esk8b/Elektroskate_Controller/PCB/BamBam-Sensor-holder-minimal/Sensor v1.2.dxf

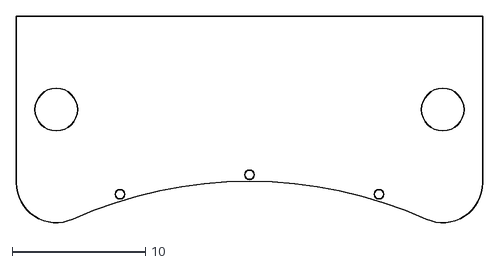
[picture p1: CAD file, 2015-05-01]
PCB/BamBam-Sensor-holder-minimal/Sensor v1.2.dxf
35.0 x 15.6
