esk8b/Elektroskate_Controller/PCB/BamBam-Sensor-holder-minimal/BamBam-Sensor-holder-minimal.pdf

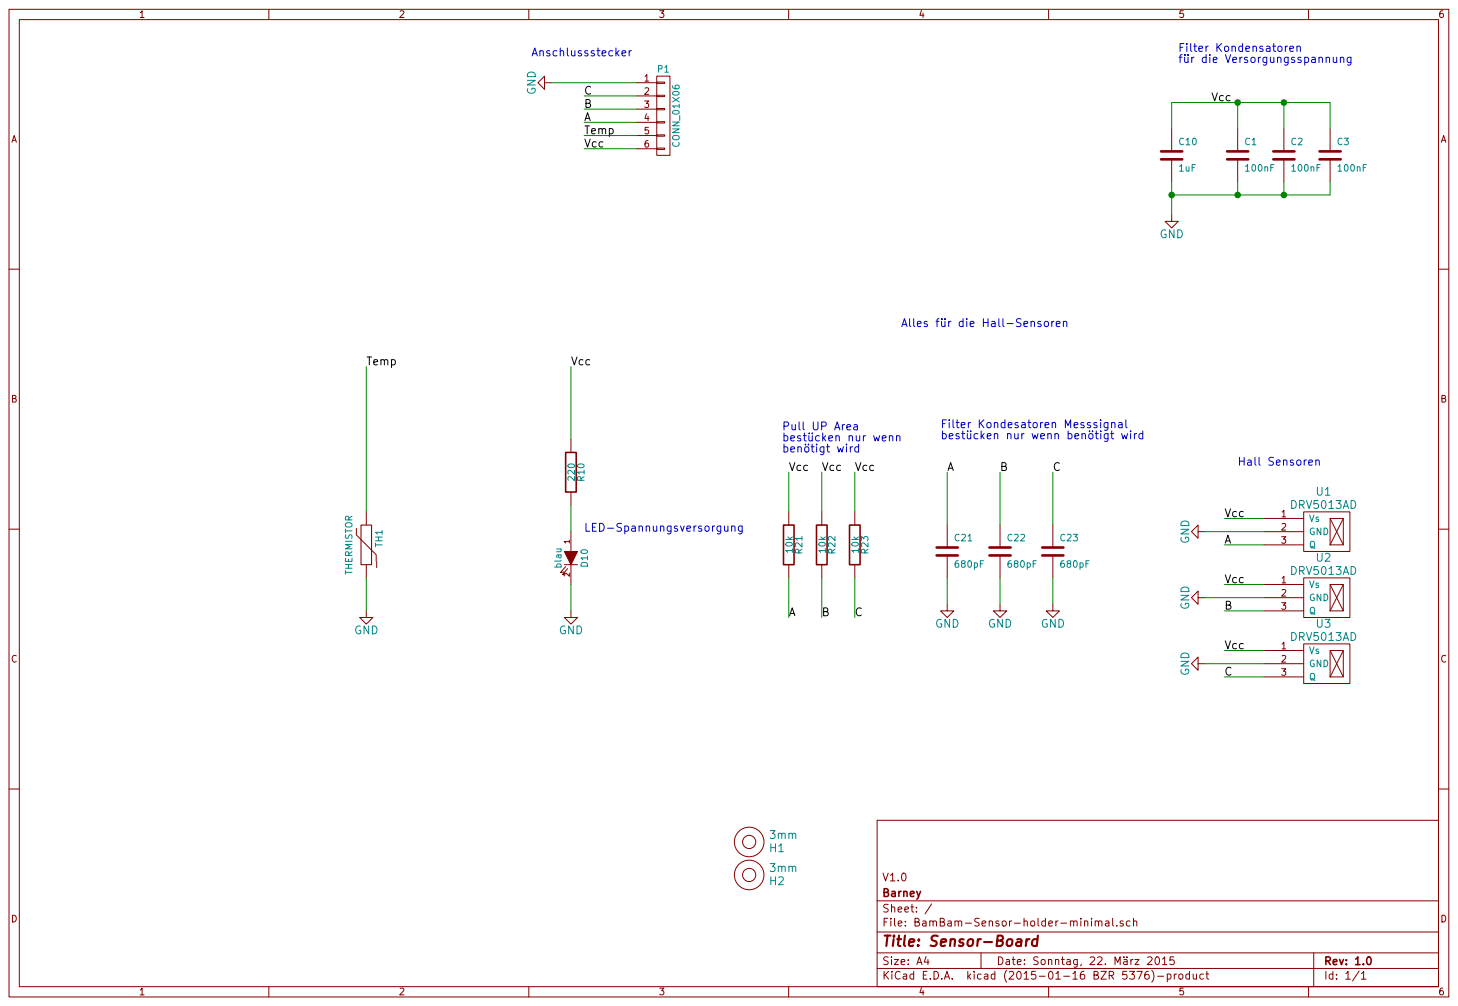
[picture p2: page 1]

Filter Kondesatoren Messsignal
bestücken nur wenn benötigt wird

File: BamBam-Sensor-holder-minimal.sch Sheet: / Barney V1.0 220 R10

Id: 1/1 Title: Sensor-Board
