esk8b/Elektroskate_Controller/PCB/BamBam BoardController/BamBam BoardController.pdf

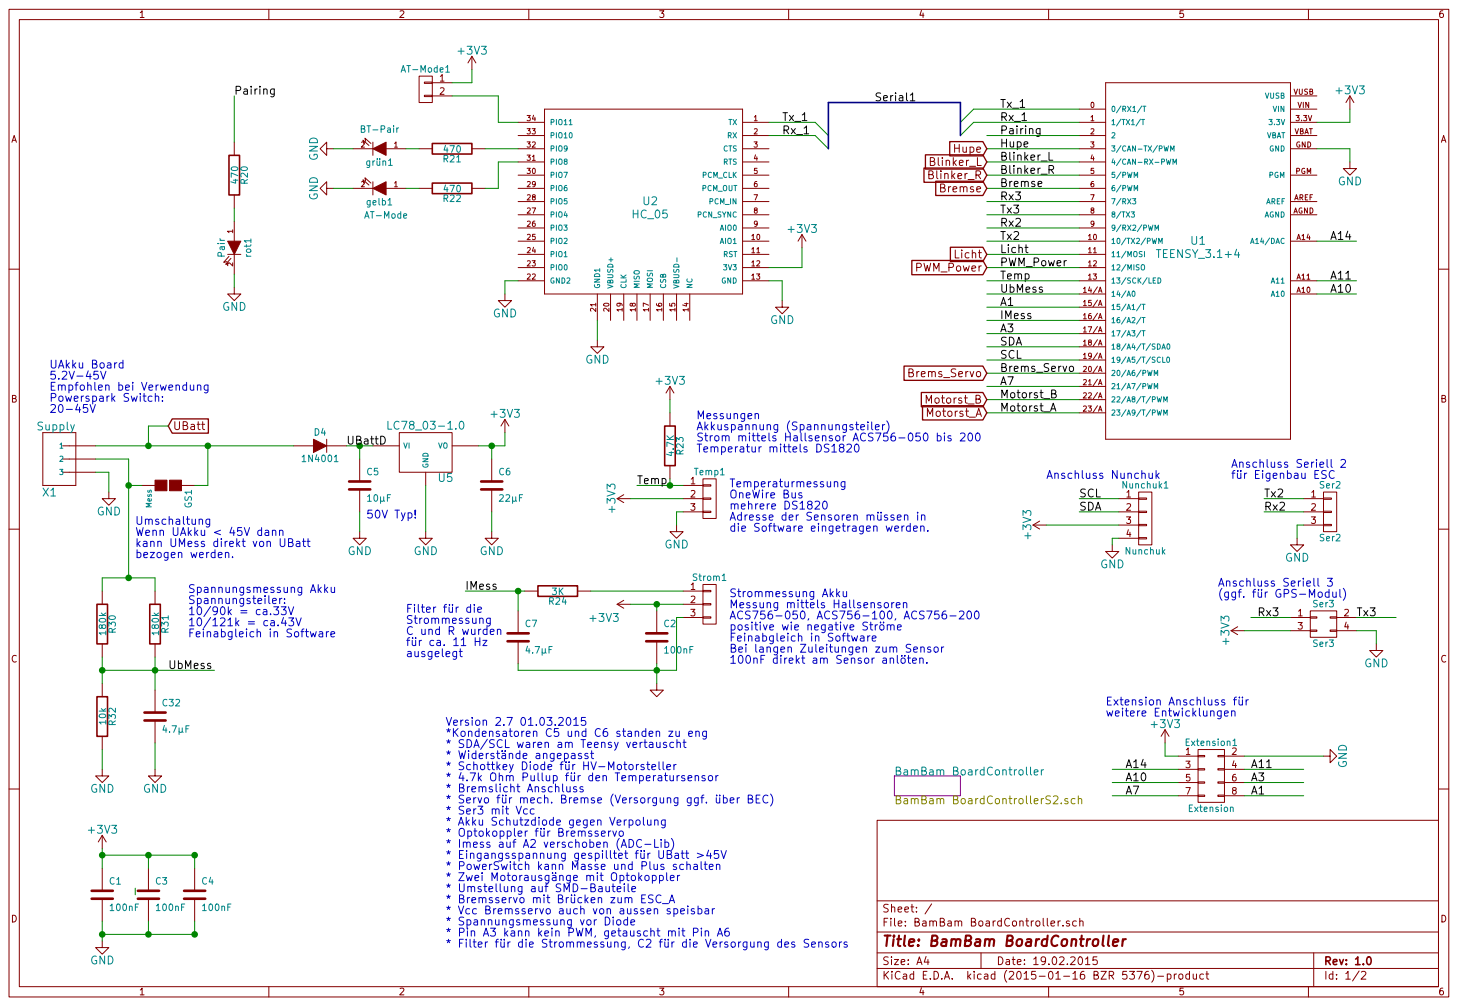
[picture p3: page 1]

100nF direkt am Sensor anlöten. +3V34.7K R23

Akkuspannung (Spannungsteiler)
Strom mittels Hallsensor ACS756-050 bis 200

Temperaturmessung
OneWire Bus
mehrere DS1820
Adresse der Sensoren müssen in
die Software eingetragen werden.

IMess Filter für die Strommessung

Strommessung Akku
Messung mittels Hallsensoren
ACS756-050, ACS756-100, ACS756-200
positive wie negative Ströme
Feinabgleich in Software
Bei langen Zuleitungen zum Sensor

*Kondensatoren C5 und C6 standen zu eng
* SDA/SCL waren am Teensy vertauscht
* Widerstände angepasst
* Schottkey Diode für HV-Motorsteller
* 4.7k Ohm Pullup für den Temperatursensor * Bremslicht Anschluss
* Servo für mech. Bremse (Versorgung ggf. über BEC)
* Ser3 mit Vcc
* Akku Schutzdiode gegen Verpolung
* Optokoppler für Bremsservo
* Imess auf A2 verschoben (ADC-Lib)
* Eingangsspannung gespilltet für UBatt >45V
* PowerSwitch kann Masse und Plus schalten
* Zwei Motorausgänge mit Optokoppler
* Umstellung auf SMD-Bauteile
* Bremsservo mit Brücken zum ESC_A
* Vcc Bremsservo auch von aussen speisbar
* Spannungsmessung vor Diode
* Pin A3 kann kein PWM, getauscht mit Pin A6
* Filter für die Strommessung, C2 für die Versorgung des Sensors

Id: 1/2 Title: BamBam BoardController File: BamBam BoardController.sch Sheet: /

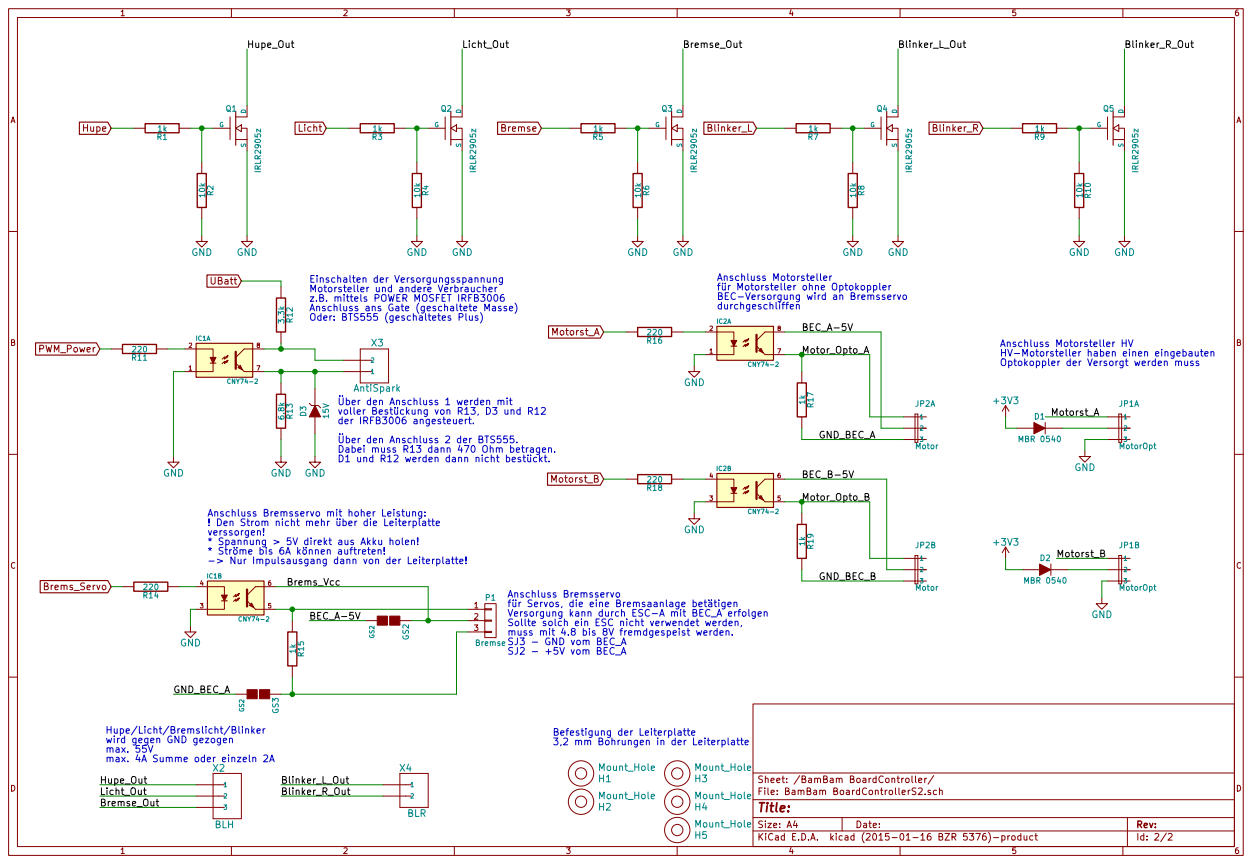
[picture p4: page 2]

Einschalten der Versorgungsspannung Motorsteller und andere Verbraucher z.B. mittels POWER MOSFET IRFB3006

für Motorsteller ohne Optokoppler
BEC-Versorgung wird an Bremsservo
durchgeschliffen

Anschluss ans Gate (geschaltete Masse)
Oder: BTS555 (geschaltetes Plus)

Anschluss Motorsteller HV HV-Motorsteller haben einen eingebauten
Optokoppler der Versorgt werden muss

Über den Anschluss 1 werden mit
voller Bestückung von R13, D3 und R12
der IRFB3006 angesteuert.
Über den Anschluss 2 der BTS555.

Anschluss Bremsservo mit hoher Leistung:
! Den Strom nicht mehr über die Leiterplatte
verssorgen!
* Spannung > 5V direkt aus Akku holen!
* Ströme bis 6A können auftreten!

für Servos, die eine Bremsaanlage betätigen
Versorgung kann durch ESC-A mit BEC_A erfolgen
Sollte solch ein ESC nicht verwendet werden,
muss mit 4.8 bis 8V fremdgespeist werden.
SJ3 - GND vom BEC_A
SJ2 - +5V vom BEC_A

Hupe/Licht/Bremslicht/Blinker
wird gegen GND gezogen max. 55V max. 4A Summe oder einzeln 2A

Befestigung der Leiterplatte
3,2 mm Bohrungen in der Leiterplatte

Id: 2/2 Title: File: BamBam BoardControllerS2.sch Sheet: /BamBam BoardController/
