esk8b/Elektroskate_Controller/PCB/BamBam-Sensor-holder-minimal/BamBam-Sensor-holder-minimal.kicad_pcb

## KiCad design PCB/BamBam-Sensor-holder-minimal/BamBam-Sensor-holder-minimal.kicad_pcb (2015-05-01)

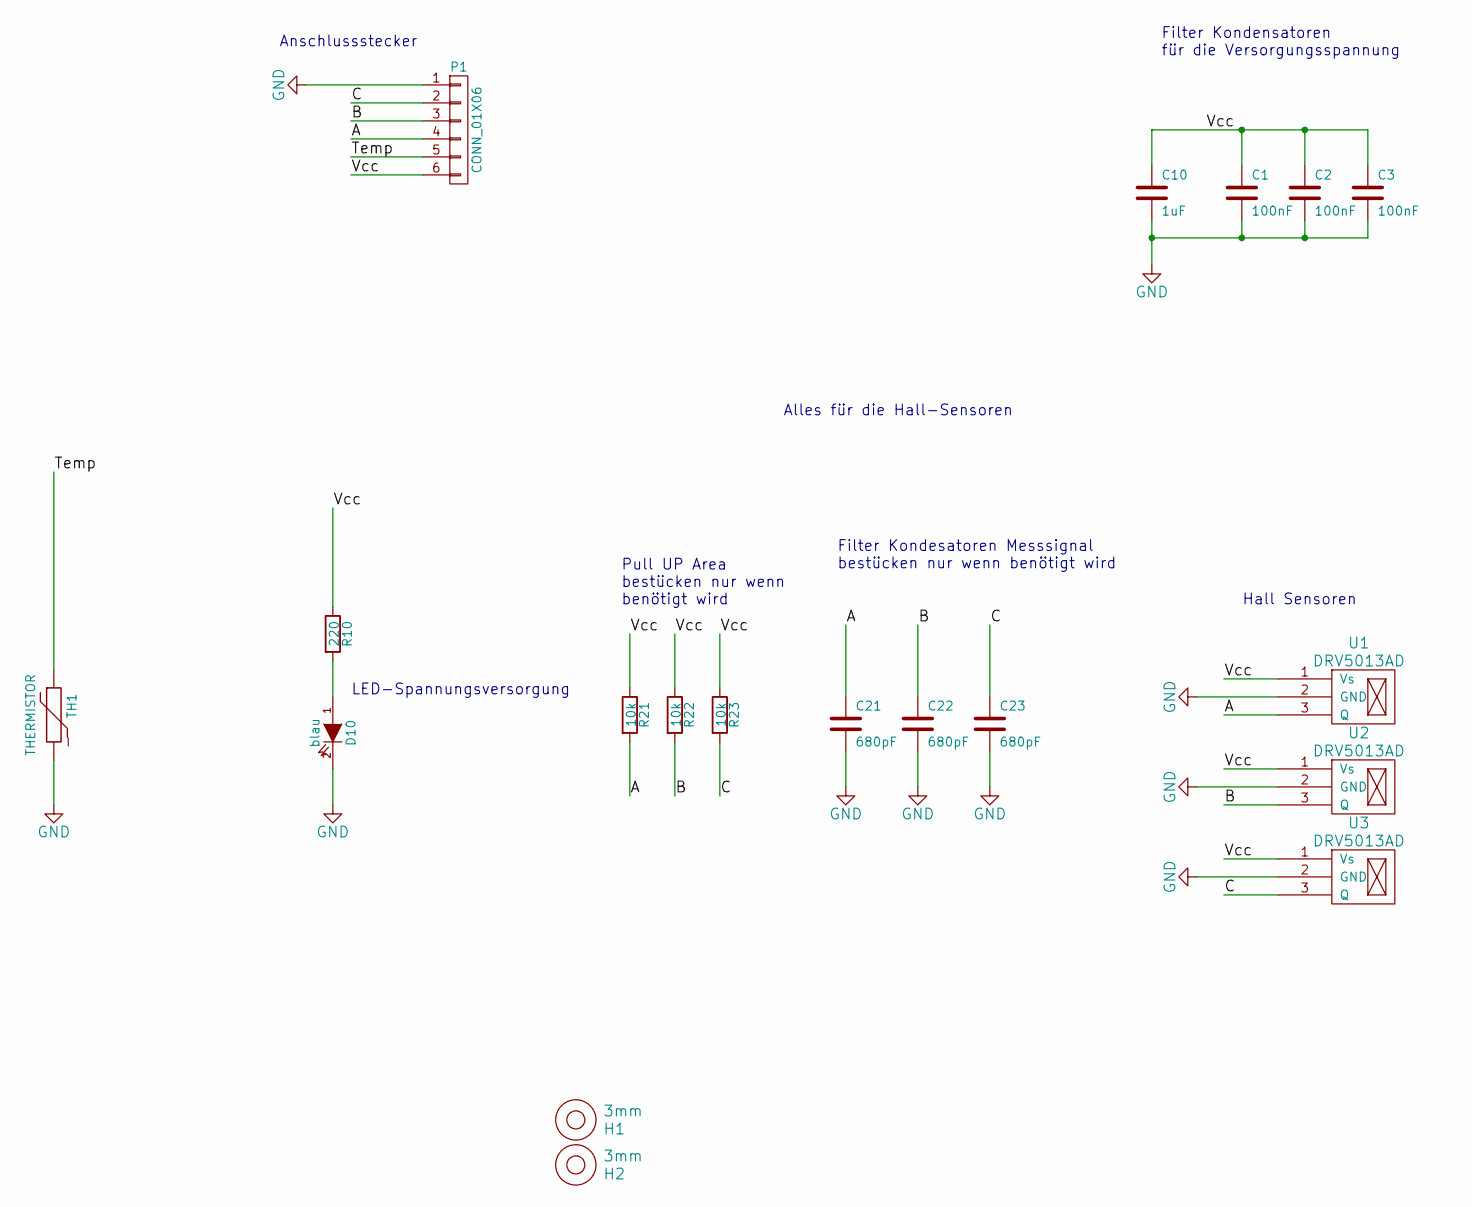
[picture p5: schematic BamBam-Sensor-holder-minimal.sch, Sensor-Board]

Parts:
C1, C2, C3: 100nF; R_1206
C10: 1uF; R_1206
C21, C22, C23: 680pF; R_1206
D10: blau; LED-0805
H1, H2: 3mm; MountingHole_3mm
P1: CONN_01X06; B6B-ZR
R10: 220; R_1206
R21, R22, R23: 10k; R_1206
TH1: THERMISTOR; R1
U1, U2, U3: DRV5013AD; P-SSO-3-2

Connections:
/A: C21.1, P1.4, R21.2, U1.3 (Q)
/B: C22.1, P1.3, R22.2, U2.3 (Q)
/C: C23.1, P1.2, R23.2, U3.3 (Q)
/Temp: P1.5, TH1.1
/Vcc: C1.1, C2.1, C3.1, C10.1, P1.6, R10.1, R21.1, R22.1, R23.1, U1.1 (Vs), U2.1 (Vs), U3.1 (Vs)
GND: C1.2, C2.2, C3.2, C10.2, C21.2, C22.2, C23.2, D10.2 (K), P1.1, TH1.2, U1.2 (GND), U2.2 (GND), U3.2 (GND)
unnamed: D10.1 (A), R10.2

Notes on the sheet:
Pull UP Area bestücken nur wenn benötigt wird
LED-Spannungsversorgung
Anschlussstecker
Filter Kondensatoren für die Versorgungsspannung
Hall Sensoren
Filter Kondesatoren Messsignal bestücken nur wenn benötigt wird
Alles für die Hall-Sensoren

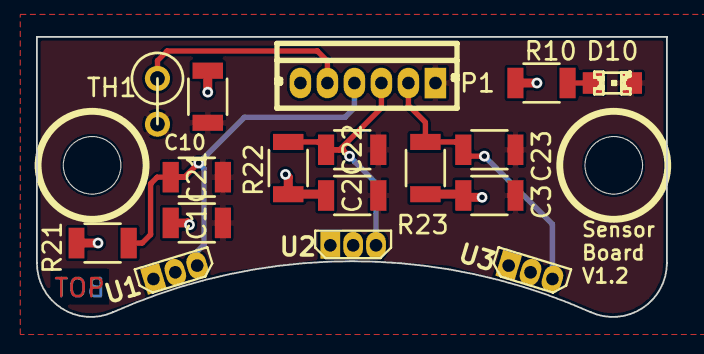
[picture p6: board BamBam-Sensor-holder-minimal.kicad_pcb from above]

Board: 2 copper layers, 35.0 x 15.6 mm, 19 parts (0 on the bottom side), 7 nets.
