esk8b/Elektroskate_Controller/PCB/BamBam Balancer/BamBam Balancer.kicad_pcb

## KiCad design PCB/BamBam Balancer/BamBam Balancer.kicad_pcb (2015-05-01)

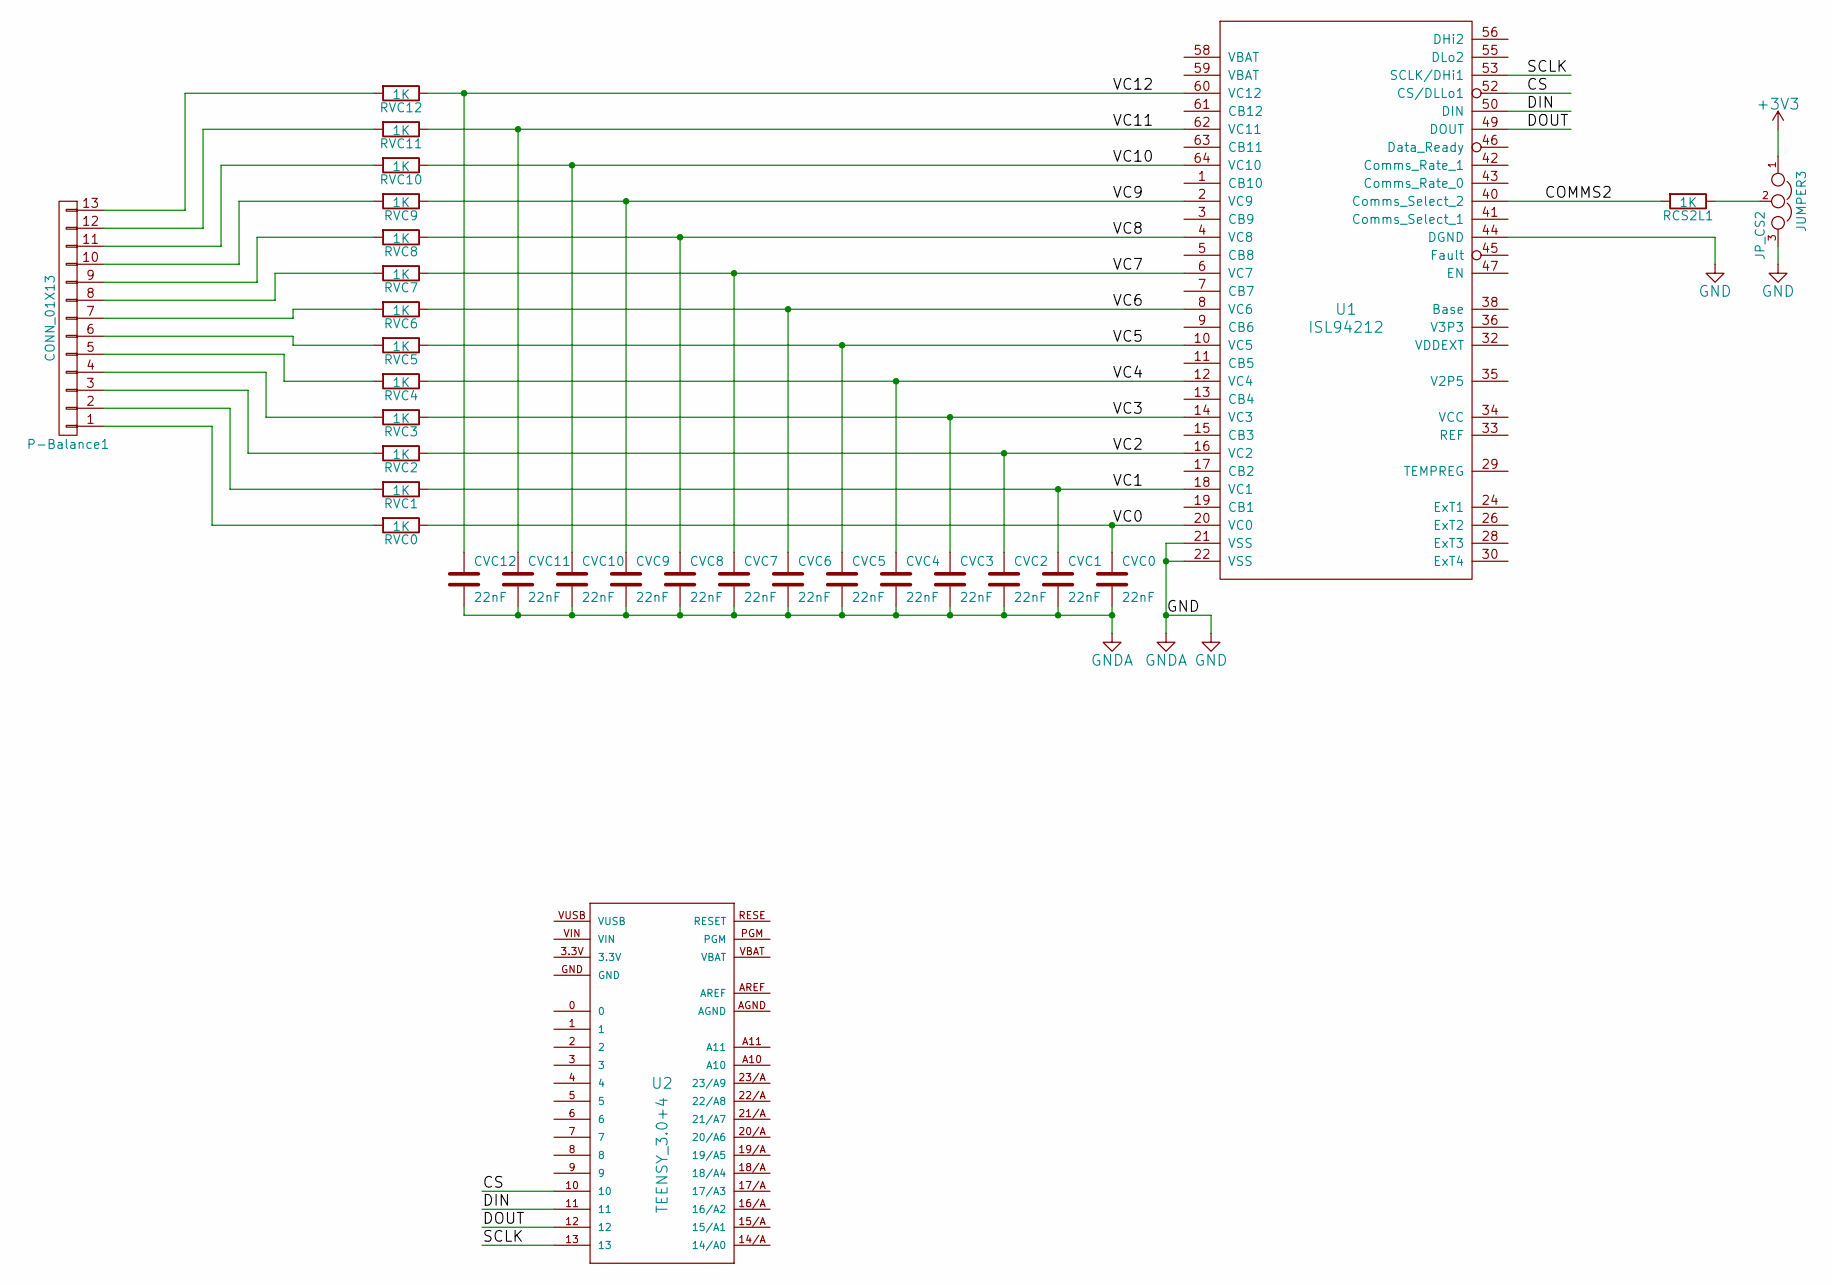
[picture p7: schematic BamBam Balancer.sch]

Parts:
CVC0, CVC1, CVC2, CVC3, CVC4, CVC5, CVC6, CVC7, CVC8, CVC9, CVC10, CVC11, CVC12: 22nF; C_1206
JP_CS2: JUMPER3; GS3
P-Balance1: CONN_01X13; Pin_Header_Angled_1x13
RCS2L1: 1K; R_1206
RVC0, RVC1, RVC2, RVC3, RVC4, RVC5, RVC6, RVC7, RVC8, RVC9, RVC10, RVC11, RVC12: 1K; R_1206
U1: ISL94212; TQFP-64_10x10mm_Pitch0.5mm
U2: TEENSY_3.0+4; Teensy_3_Series_Board_v1.0-TEENSY_3.1+4

Connections:
3.3V: U2.3.3V
+3V3: JP_CS2.1; also elsewhere on the board
/COMMS2: RCS2L1.2, U1.40 (Comms_Select_2)
/CS: U1.52 (CS/DLLo1), U2.10
/DIN: U1.50 (DIN), U2.11
/DOUT: U1.49 (DOUT), U2.12
/SCLK: U1.53 (SCLK/DHi1), U2.13
/VC0: CVC0.1, RVC0.1, U1.20 (VC0)
/VC1: CVC1.1, RVC1.1, U1.18 (VC1)
/VC2: CVC2.1, RVC2.1, U1.16 (VC2)
/VC3: CVC3.1, RVC3.1, U1.14 (VC3)
/VC4: CVC4.1, RVC4.1, U1.12 (VC4)
/VC5: CVC5.1, RVC5.1, U1.10 (VC5)
/VC6: CVC6.1, RVC6.1, U1.8 (VC6)
/VC7: CVC7.1, RVC7.1, U1.6 (VC7)
/VC8: CVC8.1, RVC8.1, U1.4 (VC8)
/VC9: CVC9.1, RVC9.1, U1.2 (VC9)
/VC10: CVC10.1, RVC10.1, U1.64 (VC10)
/VC11: CVC11.1, RVC11.1, U1.62 (VC11)
/VC12: CVC12.1, RVC12.1, U1.60 (VC12)
unnamed: JP_CS2.2, RCS2L1.1
unnamed: P-Balance1.1, RVC0.2
unnamed: P-Balance1.2, RVC1.2
unnamed: P-Balance1.3, RVC2.2
unnamed: P-Balance1.4, RVC3.2
unnamed: P-Balance1.5, RVC4.2
unnamed: P-Balance1.6, RVC5.2
unnamed: P-Balance1.7, RVC6.2
unnamed: P-Balance1.8, RVC7.2
unnamed: P-Balance1.9, RVC8.2
unnamed: P-Balance1.10, RVC9.2
unnamed: P-Balance1.11, RVC10.2
unnamed: P-Balance1.12, RVC11.2
unnamed: P-Balance1.13, RVC12.2

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
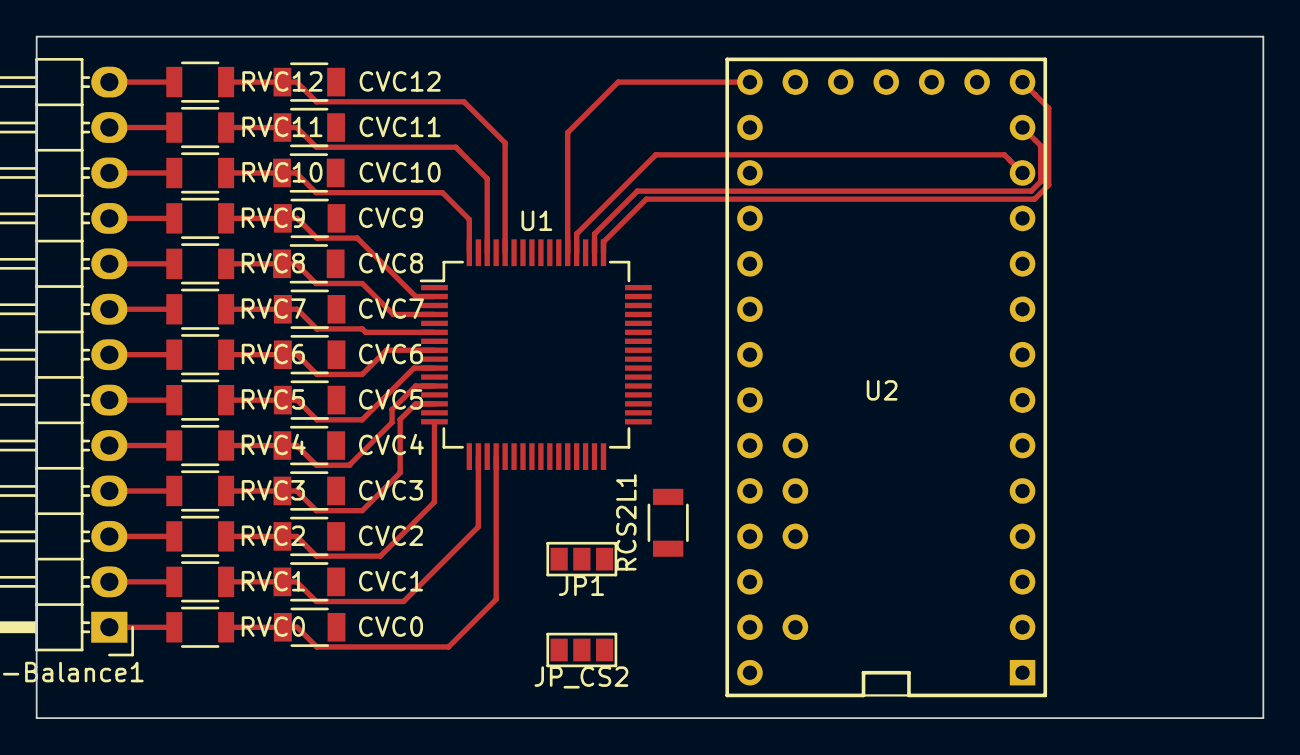
[picture p8: board BamBam Balancer.kicad_pcb from above]

Board: 2 copper layers, 68.6 x 38.1 mm, 32 parts (0 on the bottom side), 34 nets.

Other parts of the board:
JP1: JUMPER3; GS3

Their connections:
+3V3: JP1.1; also elsewhere on the board
