esk8b/Elektroskate_Controller/PCB/BamBam BoardController/BamBam BoardController.kicad_pcb

## KiCad design PCB/BamBam BoardController/BamBam BoardController.kicad_pcb (2015-05-26)

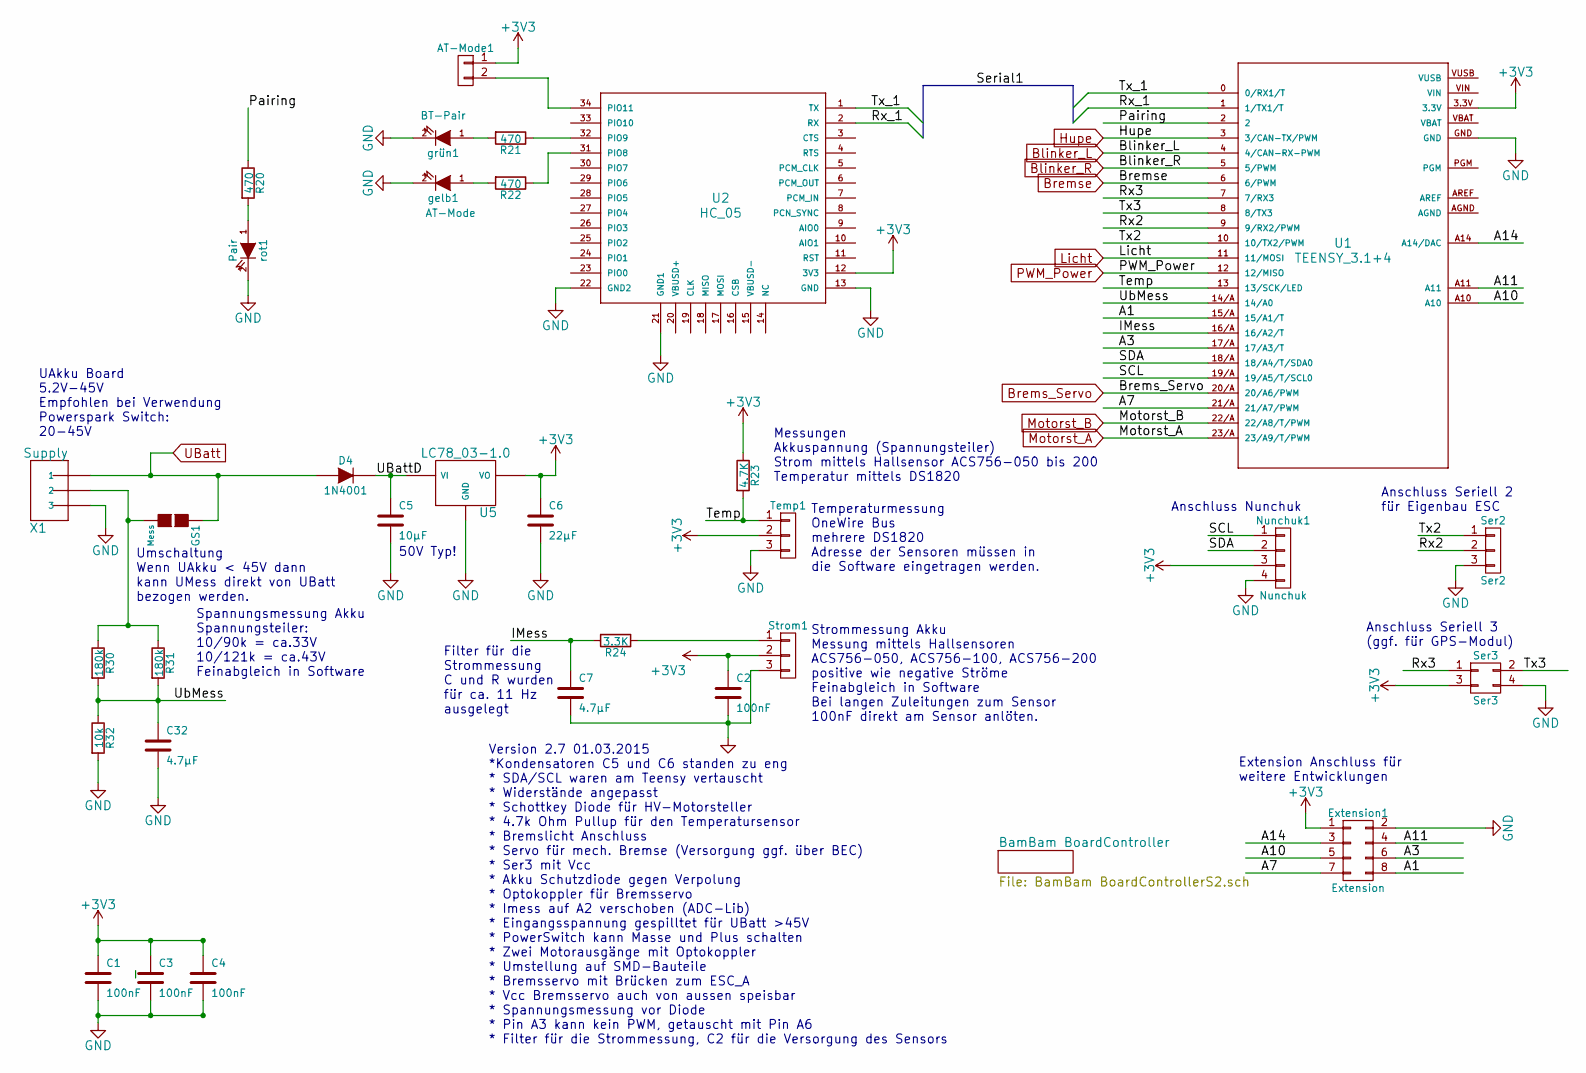
[picture p9: schematic BamBam BoardController.sch]

Parts:
AT-Mode1: AT-Mode; Pin_Header_Straight_1x02
C1, C2, C3, C4: 100nF; C_1206
C5: 10µF; C_1206
C6: 22µF; C_1206
C7, C32: 4.7µF; C_1206
D4: 1N4001; SOD123F-REFLOW
Extension1: Extension; Pin_Header_Straight_2x04
GS1: Mess; GS2
Nunchuk1: Nunchuk; Pin_Header_Straight_1x04
R20, R21, R22: 470; R_1206
R23: 4.7K; R_1206
R24: 3.3K; R_1206
R30, R31: 180k; R_1206
R32: 10k; R_1206
Ser2: Ser2; Pin_Header_Angled_1x03
Ser3: Ser3; Pin_Header_Straight_2x02
Strom1: Strom; Pin_Header_Angled_1x03
Temp1: Temp; Pin_Header_Angled_1x03
U1: TEENSY_3.1+4; Teensy_3_Series_Board_v1.0-TEENSY_3.1+4
U2: HC_05; ITEAD_HC-05
U5: LC78_03-1.0; Gaptec-LC78_03
X1: Supply; con-pss254_reichelt-03W
gelb1: AT-Mode; LED-0805
grün1: BT-Pair; LED-0805
rot1: Pair; LED-0805

Connections:
+3V3: AT-Mode1.1, C1.1, C2.1, C3.1, C4.1, C6.1, Extension1.1, Nunchuk1.3, R23.1, Ser3.3, Strom1.2, Temp1.2, U1.3.3V, U2.12 (3V3), U5.3 (VO); also elsewhere on the board
/A1: Extension1.8, U1.15/A (15/A1/T)
/A3: Extension1.6, U1.17/A (17/A3/T)
/A7: Extension1.7, U1.21/A (21/A7/PWM)
/A10: Extension1.5, U1.A10
/A11: Extension1.4, U1.A11
/A14: Extension1.3, U1.A14 (A14/DAC)
/IMess: C7.1, R24.2, U1.16/A (16/A2/T)
/Pairing: R20.1, U1.2
/Rx2: Ser2.2, U1.9 (9/RX2/PWM)
/Rx3: Ser3.1, U1.7 (7/RX3)
/Rx_1: U1.1 (1/TX1/T), U2.2 (RX)
/SCL: Nunchuk1.1, U1.19/A (19/A5/T/SCL0)
/SDA: Nunchuk1.2, U1.18/A (18/A4/T/SDA0)
/Temp: R23.2, Temp1.1, U1.13 (13/SCK/LED)
/Tx2: Ser2.1, U1.10 (10/TX2/PWM)
/Tx3: Ser3.2, U1.8 (8/TX3)
/Tx_1: U1.0 (0/RX1/T), U2.1 (TX)
/UBattD: C5.1, D4.2 (K), U5.1 (VI)
/UbMess: C32.1, R30.2, R31.2, R32.1, U1.14/A (14/A0)
Blinker_L: U1.4 (4/CAN-RX-PWM); also elsewhere on the board
Blinker_R: U1.5 (5/PWM); also elsewhere on the board
Brems_Servo: U1.20/A (20/A6/PWM); also elsewhere on the board
Bremse: U1.6 (6/PWM); also elsewhere on the board
GND: C1.2, C2.2, C3.2, C4.2, C5.2, C6.2, C7.2, C32.2, Extension1.2, Nunchuk1.4, R32.2, Ser2.3, Ser3.4, Strom1.3, Temp1.3, U1.GND, U1.GND1 (GND), U2.13 (GND), U2.21 (GND1), U2.22 (GND2), U5.2 (GND), X1.P$3 (3), gelb1.2 (K), grün1.2 (K), rot1.2 (K); also elsewhere on the board
Hupe: U1.3 (3/CAN-TX/PWM); also elsewhere on the board
Licht: U1.11 (11/MOSI); also elsewhere on the board
Motorst_A: U1.23/A (23/A9/T/PWM); also elsewhere on the board
Motorst_B: U1.22/A (22/A8/T/PWM); also elsewhere on the board
unnamed: AT-Mode1.2, U2.34 (PIO11)
unnamed: GS1.2 (G2), R30.1, R31.1, X1.P$2 (2)
unnamed: R20.2, rot1.1 (A)
unnamed: R21.1, U2.32 (PIO9)
unnamed: R21.2, grün1.1 (A)
unnamed: R22.1, U2.31 (PIO8)
unnamed: R22.2, gelb1.1 (A)
unnamed: R24.1, Strom1.1
PWM_Power: U1.12 (12/MISO); also elsewhere on the board
UBatt: D4.1 (A), GS1.1 (G1), X1.P$1 (1); also elsewhere on the board

Notes on the sheet:
Extension Anschluss für weitere Entwicklungen
Version 2.7 01.03.2015 *Kondensatoren C5 und C6 standen zu eng * SDA/SCL waren am Teensy vertauscht * Widerstände angepasst * Schottkey Diode für HV-Motorsteller * 4.7k Ohm Pullup für den Temperatursensor * Bremslicht Anschluss * Servo für mech. Bremse (Versorgung ggf. über BEC) * Ser3 mit Vcc * Ak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
Anschluss Nunchuk
Anschluss Seriell 2 für Eigenbau ESC
Anschluss Seriell 3 (ggf. für GPS-Modul)
Strommessung Akku Messung mittels Hallsensoren ACS756-050, ACS756-100, ACS756-200 positive wie negative Ströme Feinabgleich in Software Bei langen Zuleitungen zum Sensor 100nF direkt am Sensor anlöten.
Temperaturmessung OneWire Bus mehrere DS1820 Adresse der Sensoren müssen in die Software eingetragen werden.
UAkku Board 5.2V-45V Empfohlen bei Verwendung Powerspark Switch: 20-45V
Umschaltung Wenn UAkku < 45V dann kann UMess direkt von UBatt bezogen werden.
Spannungsmessung Akku Spannungsteiler: 10/90k = ca.33V 10/121k = ca.43V Feinabgleich in Software
Messungen Akkuspannung (Spannungsteiler) Strom mittels Hallsensor ACS756-050 bis 200 Temperatur mittels DS1820
Filter für die Strommessung C und R wurden für ca. 11 Hz ausgelegt
50V Typ!

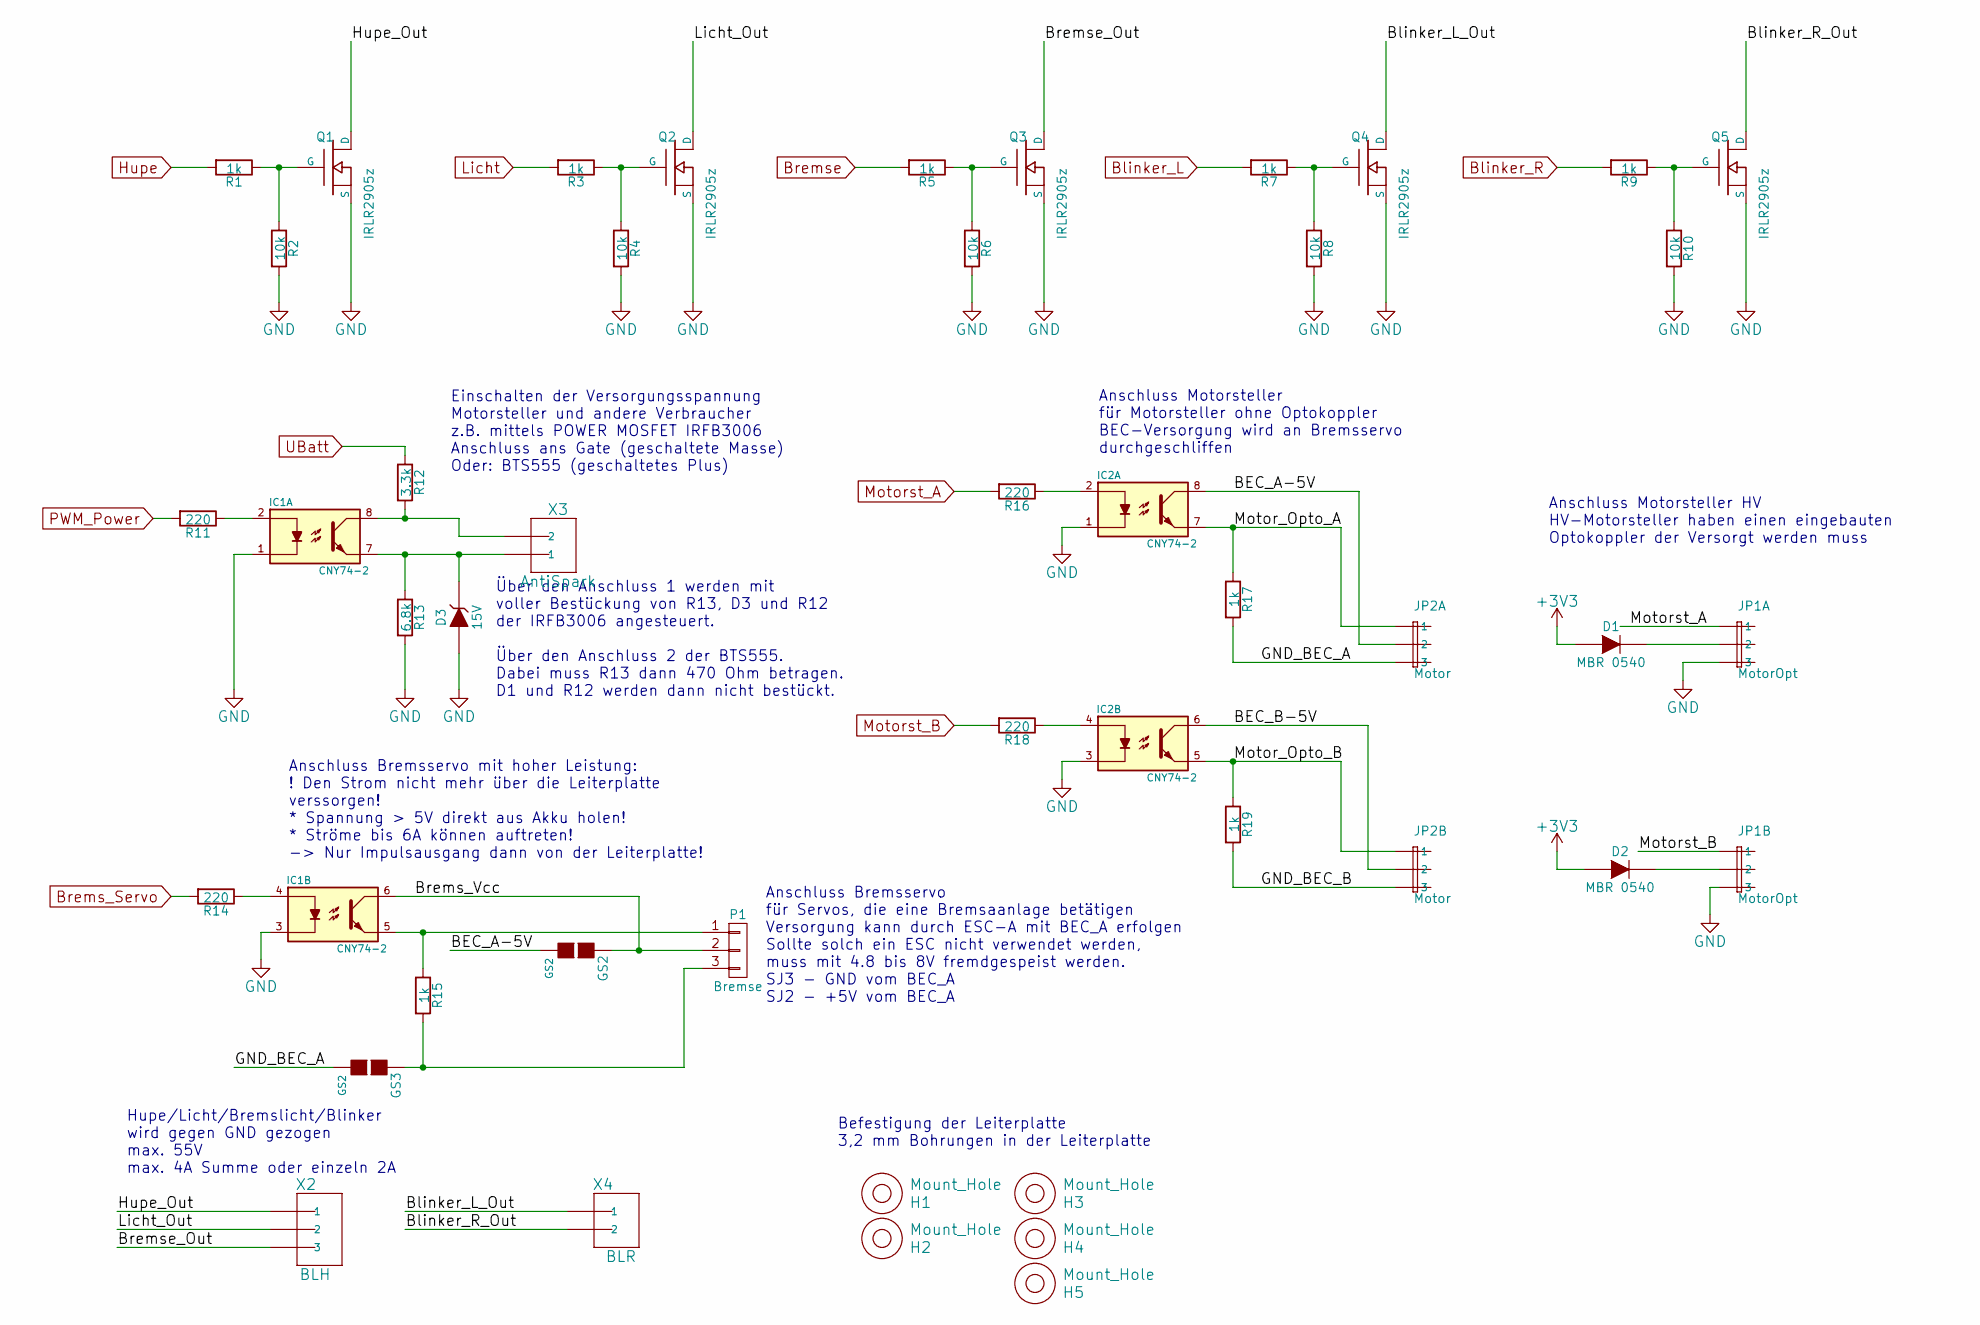
[picture p10: schematic BamBam BoardControllerS2.sch]

Parts:
D1, D2: MBR 0540; SOD-123
D3: 15V; DO-35
GS2, GS3: GS2
H1, H2, H3, H4, H5: Mount_Hole; MountingHole_3mm_new
IC1, IC2: CNY74-2; DIP-8__300
JP1: MotorOpt; connector-JP3Q
JP2: Motor; connector-JP3Q
P1: Bremse; Pin_Header_Angled_1x03
Q1, Q2, Q3, Q4, Q5: IRLR2905z; DPAK-3_GDS
R1, R3, R5, R7, R9, R15, R17, R19: 1k; R_1206
R2, R4, R6, R8, R10: 10k; R_1206
R11, R14, R16, R18: 220; R_1206
R12: 3.3k; R_1206
R13: 6.8k; R_1206
X2: BLH; con-pss254_reichelt-03W
X3: AntiSpark; con-pss254_reichelt-02W
X4: BLR; con-pss254_reichelt-02W

Connections:
+3V3: D1.1 (A), D2.1 (A); also elsewhere on the board
/BamBam BoardController/BEC_A-5V: GS2.2 (G2), IC2.8, JP2.2A (2)
/BamBam BoardController/BEC_B-5V: IC2.6, JP2.2B (2)
/BamBam BoardController/Blinker_L_Out: Q4.D, X4.P$1 (1)
/BamBam BoardController/Blinker_R_Out: Q5.D, X4.P$2 (2)
/BamBam BoardController/Brems_Vcc: GS2.1 (G1), IC1.6, P1.2
/BamBam BoardController/Bremse_Out: Q3.D, X2.P$3 (3)
/BamBam BoardController/GND_BEC_A: GS3.2 (G2), JP2.3A (3), R17.2
/BamBam BoardController/GND_BEC_B: JP2.3B (3), R19.2
/BamBam BoardController/Hupe_Out: Q1.D, X2.P$1 (1)
/BamBam BoardController/Licht_Out: Q2.D, X2.P$2 (2)
/BamBam BoardController/Motor_Opto_A: IC2.7, JP2.1A (1), R17.1
/BamBam BoardController/Motor_Opto_B: IC2.5, JP2.1B (1), R19.1
Blinker_L: R7.2; also elsewhere on the board
Blinker_R: R9.2; also elsewhere on the board
Brems_Servo: R14.2; also elsewhere on the board
Bremse: R5.2; also elsewhere on the board
GND: D3.1 (A), IC1.1, IC1.3, IC2.1, IC2.3, JP1.3A (3), JP1.3B (3), Q1.S, Q2.S, Q3.S, Q4.S, Q5.S, R2.2, R4.2, R6.2, R8.2, R10.2, R13.2; also elsewhere on the board
Hupe: R1.2; also elsewhere on the board
Licht: R3.2; also elsewhere on the board
Motorst_A: JP1.1A (1), R16.2; also elsewhere on the board
Motorst_B: JP1.1B (1), R18.2; also elsewhere on the board
unnamed: D1.2 (K), JP1.2A (2)
unnamed: D2.2 (K), JP1.2B (2)
unnamed: D3.2 (K), IC1.7, R13.1, X3.P$1 (1)
unnamed: GS3.1 (G1), P1.3, R15.2
unnamed: IC1.2, R11.1
unnamed: IC1.4, R14.1
unnamed: IC1.5, P1.1, R15.1
unnamed: IC1.8, R12.2, X3.P$2 (2)
unnamed: IC2.2, R16.1
unnamed: IC2.4, R18.1
unnamed: Q1.G, R1.1, R2.1
unnamed: Q2.G, R3.1, R4.1
unnamed: Q3.G, R5.1, R6.1
unnamed: Q4.G, R7.1, R8.1
unnamed: Q5.G, R9.1, R10.1
PWM_Power: R11.2; also elsewhere on the board
UBatt: R12.1; also elsewhere on the board

Notes on the sheet:
Hupe/Licht/Bremslicht/Blinker wird gegen GND gezogen max. 55V max. 4A Summe oder einzeln 2A
Einschalten der Versorgungsspannung Motorsteller und andere Verbraucher z.B. mittels POWER MOSFET IRFB3006 Anschluss ans Gate (geschaltete Masse) Oder: BTS555 (geschaltetes Plus)
Über den Anschluss 1 werden mit voller Bestückung von R13, D3 und R12 der IRFB3006 angesteuert. Über den Anschluss 2 der BTS555. Dabei muss R13 dann 470 Ohm betragen. D1 und R12 werden dann nicht bestückt.
Anschluss Motorsteller für Motorsteller ohne Optokoppler BEC-Versorgung wird an Bremsservo durchgeschliffen
Anschluss Bremsservo mit hoher Leistung: ! Den Strom nicht mehr über die Leiterplatte verssorgen! * Spannung > 5V direkt aus Akku holen! * Ströme bis 6A können auftreten! -> Nur Impulsausgang dann von der Leiterplatte!
Anschluss Bremsservo für Servos, die eine Bremsaanlage betätigen Versorgung kann durch ESC-A mit BEC_A erfolgen Sollte solch ein ESC nicht verwendet werden, muss mit 4.8 bis 8V fremdgespeist werden. SJ3 - GND vom BEC_A SJ2 - +5V vom BEC_A
Anschluss Motorsteller HV HV-Motorsteller haben einen eingebauten Optokoppler der Versorgt werden muss
Befestigung der Leiterplatte 3,2 mm Bohrungen in der Leiterplatte

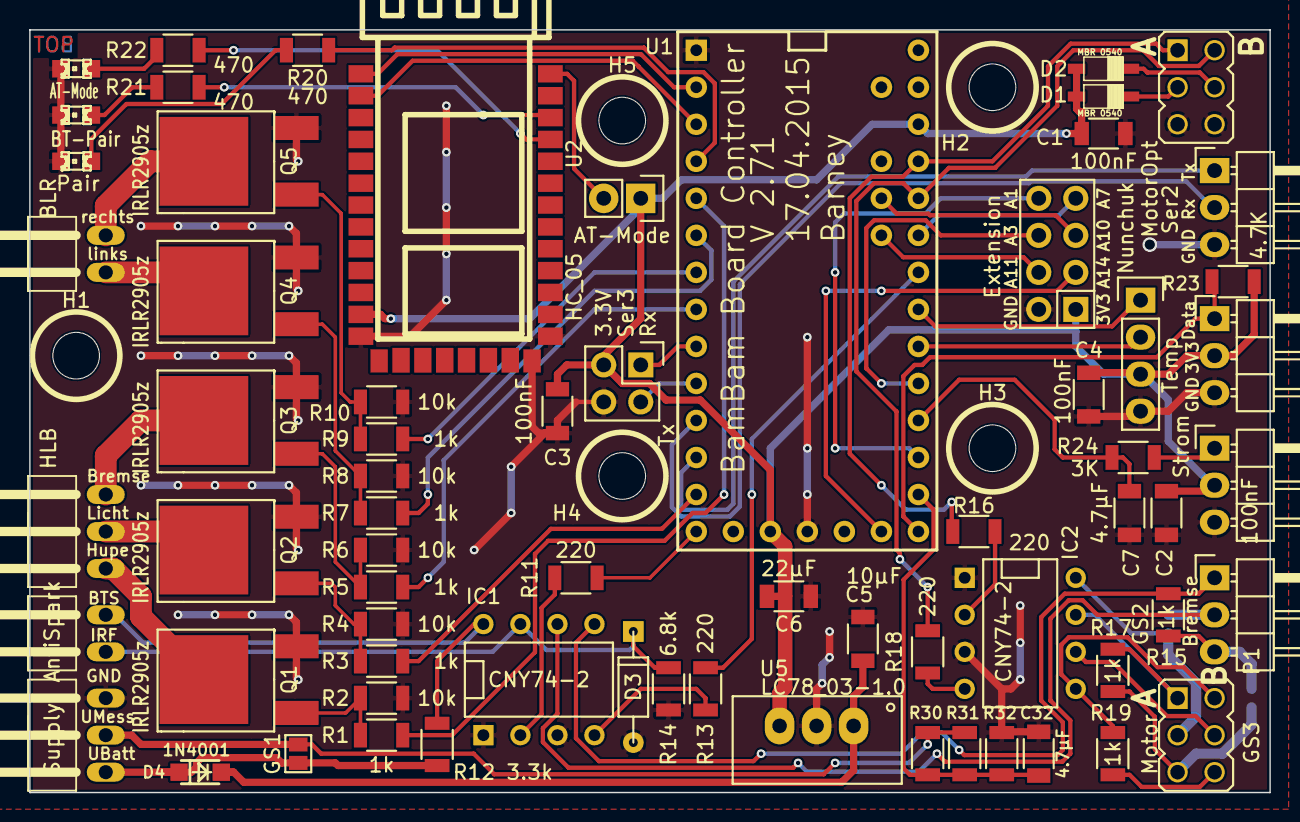
[picture p11: board BamBam BoardController.kicad_pcb from above]

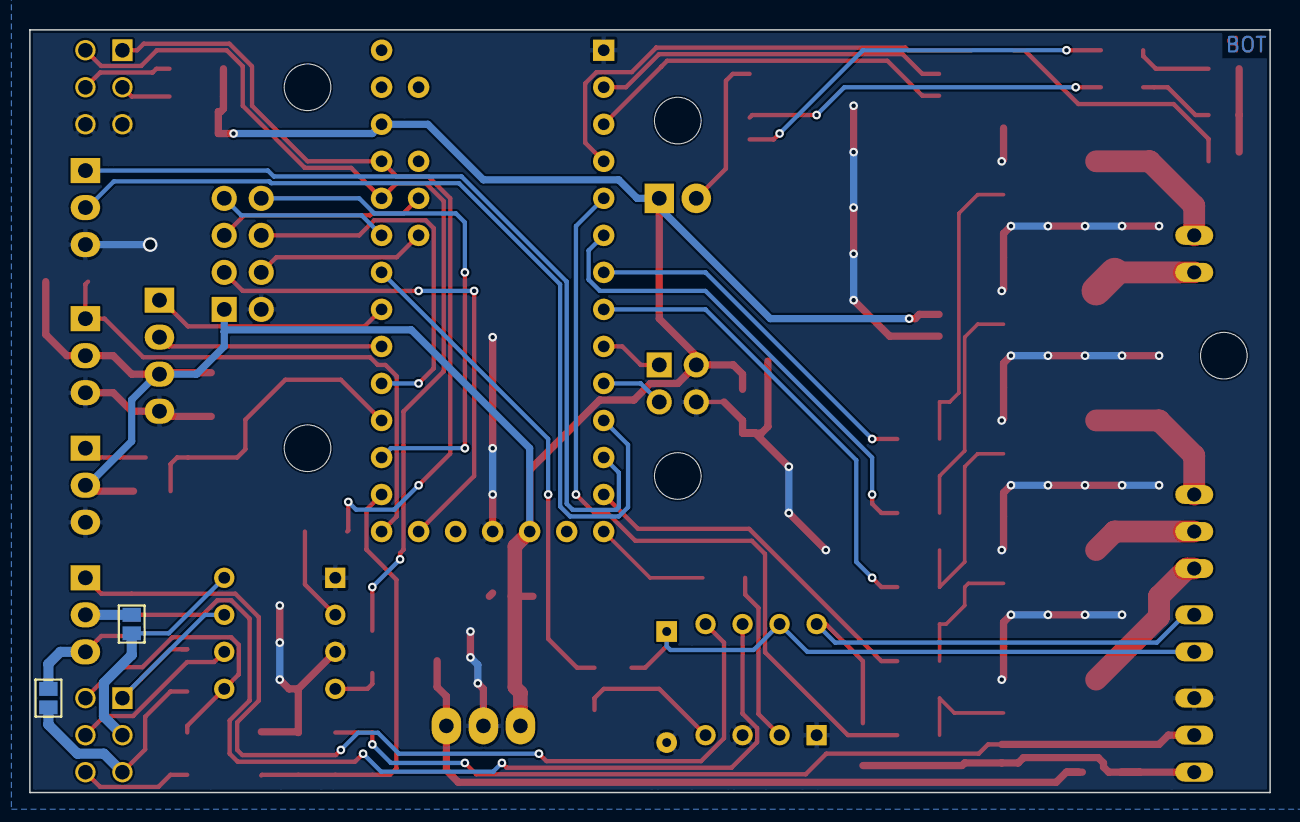
[picture p12: board BamBam BoardController.kicad_pcb from below]

Board: 2 copper layers, 85.1 x 52.3 mm, 74 parts (2 on the bottom side), 66 nets.
