esk8b/Elektroskate_Controller/(commit log)

2015-01-11 4.1p0-28.12.2014 Barney: Die Leiterplattenversion v2.5 hat jetzt den Stromsensor an A2. Dadurch kann die ADC-Lib die beiden ADCs getrennt im Teensy parametrieren. Durch die neue Leiterplatte wird der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
2015-01-11 Neue Ordnerstruktur
    [DRILEGEND.CFG, Elektroskate Teensy 08.08.2014.brd, Elektroskate Teensy 08.08.2014.sch, Elektroskate Teensy 20141205.brd, Elektroskate Teensy 20141205.sch, Elektroskate Teensy 20141227.brd, Elektroskate Teensy 20141227.sch]
2015-01-14 Die Strom und Spannungsmessung erfolgt jetzt über die zwei eingebauten ADC-Kanäle ADC_0 und ADC_1. Die Mittelwertbildung wurde von 8 auf 32 angehoben. Eine Messung würde 433µs dauern, es wurde aber d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
2015-01-31 Umstellung auf die Nunchuk Teensy Lib
2015-03-03 Anpassung der Software auf Teensyduino 1.22 und Arduino 1.6.x
    [DRILEGEND.CFG, Elektroskate Teensy 08.08.2014.brd, Elektroskate Teensy 08.08.2014.sch, Elektroskate Teensy 20141205.brd, Elektroskate Teensy 20141205.sch, Elektroskate Teensy 20141227.brd, Elektroskate Teensy 20141227.sch]
2015-03-03 KiCad Projektdateien
    [Teensy.kicad_pcb, Teensy.sch, TeensyS2.sch]
2015-03-03 Aktuelle KiCad Datei
    [Teensy.sch]
2015-03-05 Aktuelle KiCad Daten
    [Teensy.kicad_pcb, Teensy.sch, TeensyS2.sch]
2015-03-09 Anpassungen in KiCad PCB Mount Hole hat jetzt die Bohrung 3.2mm Werte der Bauteile nicht mit "," sondern ".". Wichtig für den Export der BOM Bessere Verlegung der Spannungsmessleitung, geschützt in G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
    [Teensy.kicad_pcb, Teensy.sch]
2015-03-21 Anpassung an Arduino IDE 1.61 und Teensyduino 1.21
2015-03-28 Auf BamBam angepasst. HC-05 Rahmen lag auf Pads BrmesOpto Text durch Bremse erstezt Gerber und Drill-Dateien generiert und gesichtet
    [BamBam BoardController-B_Cu.gbr, BamBam BoardController-B_Mask.gbr, BamBam BoardController-Edge_Cuts.gbr, BamBam BoardController-F_Cu.gbr, BamBam BoardController-F_Mask.gbr, BamBam BoardController-F_SilkS.gbr, BamBam BoardController-drl_map.gbr, BamBam BoardController.drl]
2015-03-31 Bohrungen für die PC352 und PC353, sowie für die Motorstiftleisten auf 0.965 bzw. 1.0mm vergrößert. Zwei Leiterbahnen wegen Kollisionsmöglichkeit verschoben. Text auf Leiterplatte auf BamBam und Datu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
    [BamBam BoardController-B_Cu.gbr, BamBam BoardController-B_Mask.gbr, BamBam BoardController-Edge_Cuts.gbr, BamBam BoardController-F_Cu.gbr, BamBam BoardController-F_Mask.gbr, BamBam BoardController-F_SilkS.gbr, BamBam BoardController-drl_map.gbr, BamBam BoardController.drl]
2015-04-16 Anpassung an die KiCAD Libs >02/2015 Einige kleine Korrekturen am Layout Anpassung der Mounting Holes mit NTPH (nicht durch kontaktieren) Zwei Texte im PCB zugefügt (Tx und Rx Ser2)
    [BamBam BoardController-B_Cu.gbr, BamBam BoardController-B_Mask.gbr, BamBam BoardController-Edge_Cuts.gbr, BamBam BoardController-F_Cu.gbr, BamBam BoardController-F_Mask.gbr, BamBam BoardController-F_SilkS.gbr, BamBam BoardController-NPTH.drl, BamBam BoardController.drl]
2015-04-19 Ab Teensyduino 1.22 wird die Lib ADC und i2c_t3 mitgeliefert und wurde daher aus der library gelöscht. Die Umschaltung DirectDrive und Integraldrive wurde deaktiviert. Die Umschaltung muss gegen vers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
2015-05-01 Files komplett mit aktuellen Dateien aus Barneys zip-Archiv überschrieben.
    [BamBam Balancer.kicad_pcb, BamBam Balancer.sch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]
2015-05-11 Die Version 2.71 hat einige Veränderungen in den Bestückungstext bekommen, Verdeckte Texte wurden Verlagert und noch weitere Informationen an den Anschlüssen ergänzt. Eine Leiterbahn wurde im Quersch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
    [BamBam BoardController-B_Cu.gbr, BamBam BoardController-B_Mask.gbr, BamBam BoardController-Edge_Cuts.gbr, BamBam BoardController-F_Cu.gbr, BamBam BoardController-F_Mask.gbr, BamBam BoardController-F_SilkS.gbr, BamBam BoardController-NPTH.drl, BamBam BoardController.drl]
2015-05-18 Software: Polynom für die Spannungsmessung
2015-06-10 4.1p4-28.05.2015 Dude - DEBUG-Flag aus Settings.h entfernt, da ohne Verwendung. Verallgemeinerung der Ausgabe auf 2 generelle Ausgabekanle (USBSerial und BT) - Update Kommentare - Motorsteller-Offset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
2015-06-29 Anpassung fuer Arduino 1.6.5.r2 und Teensyduino 1.24 adc.h adc->setReference(ADC_REF_EXT, ADC_0); siehe Dokumentation adc Lib
2015-07-14 Die Libs für den Teensy sind jetzt wieder bei.
    [BamBam Balancer.kicad_pcb, BamBam Balancer.sch, BamBam BoardControllerS2.sch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]
2016-12-30 Add files via upload
    Notaus-Anschluss, hält den Motor an, wenn Reißleinenanschluss unterbrochen wird.
2017-09-09 Anpassung Entwicklungsumgebung
    An die aktuelle Arduino 1.8.4 und Teensyduino 1.32 Version
    ADC.h wurde verändert
