esk8b/Elektroskate_Controller/(notices)

Notices in the files:
Software/Elektroskate_Teensy31_v41p0_ADC_LIB_SwitchDriveMode_Leiterplatt/Elektroskate_Teensy31_v41p0_ADC_LIB_SwitchDriveMode_Leiterplatt.ino:
This program is free software; you can redistribute it and/or modify it under the terms of
the GNU General Public License as published by the Free Software Foundation; either
